Alpenwhale/PortfolioDisplayESP/docs/img/128x64/asset0_ytd.png

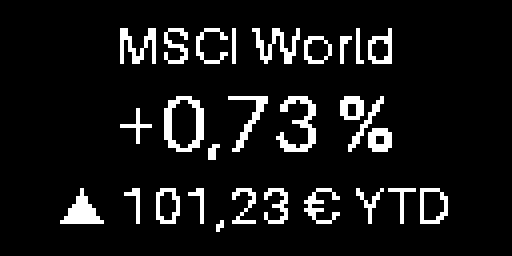
docs/img/128x64/asset0_ytd.png
