Alpenwhale/PortfolioDisplayESP/docs/img/128x64/asset3.png

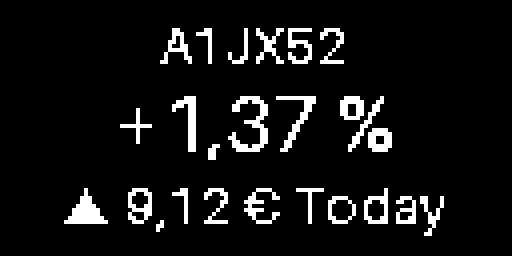
docs/img/128x64/asset3.png
