Alpenwhale/PortfolioDisplayESP/docs/img/128x64/boot.png

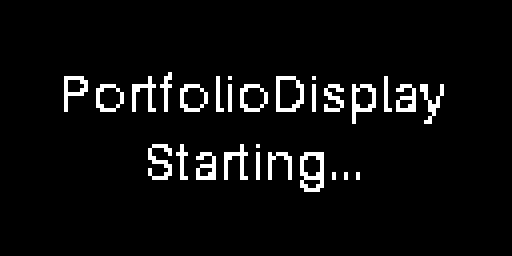
docs/img/128x64/boot.png
