Alpenwhale/PortfolioDisplayESP/docs/img/128x64/info1.png

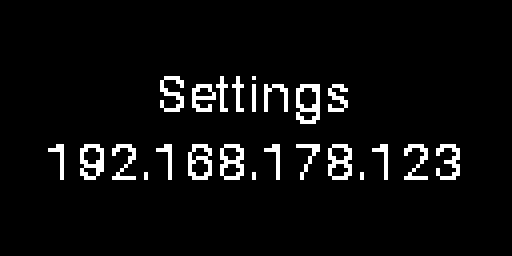
docs/img/128x64/info1.png
