Alpenwhale/PortfolioDisplayESP/docs/img/128x64/total_en.png

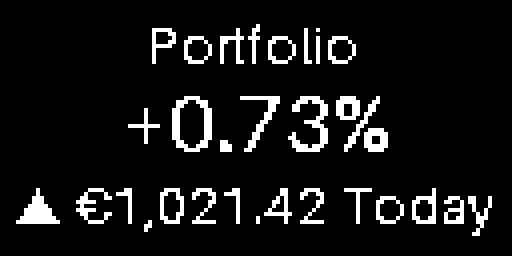
docs/img/128x64/total_en.png
