Alpenwhale/PortfolioDisplayESP/docs/img/128x64/total_minimal.png

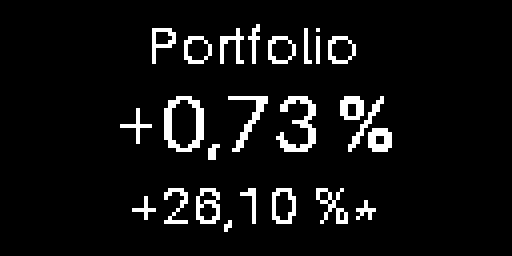
docs/img/128x64/total_minimal.png
