Alpenwhale/PortfolioDisplayESP/docs/img/128x64/total_novalue.png

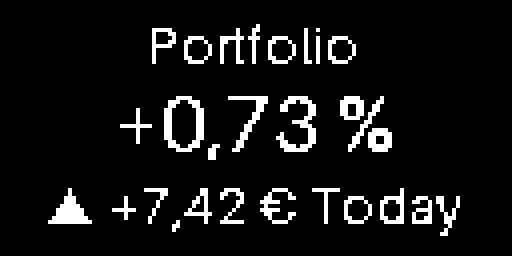
docs/img/128x64/total_novalue.png
