Alpenwhale/PortfolioDisplayESP/docs/img/320x240/asset3.png

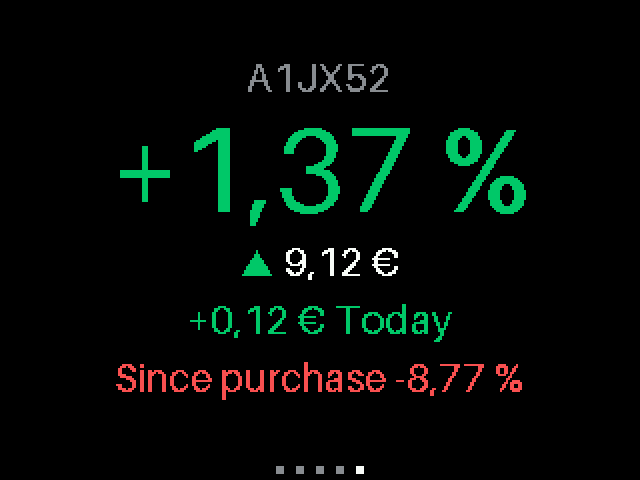
docs/img/320x240/asset3.png
