Alpenwhale/PortfolioDisplayESP/docs/img/320x240/boot.png

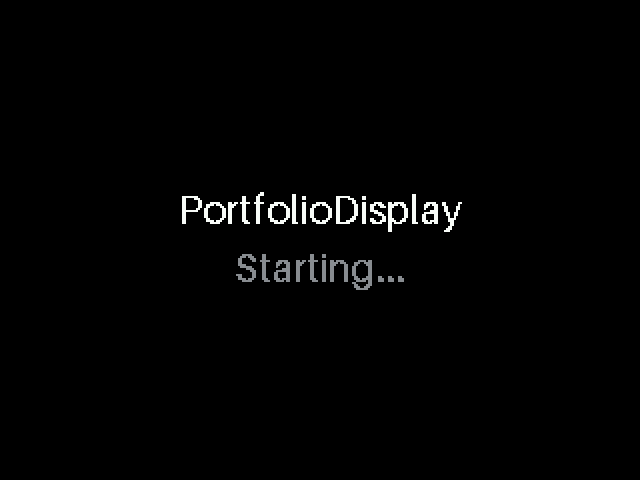
docs/img/320x240/boot.png
