Alpenwhale/PortfolioDisplayESP/docs/img/320x240/total_novalue.png

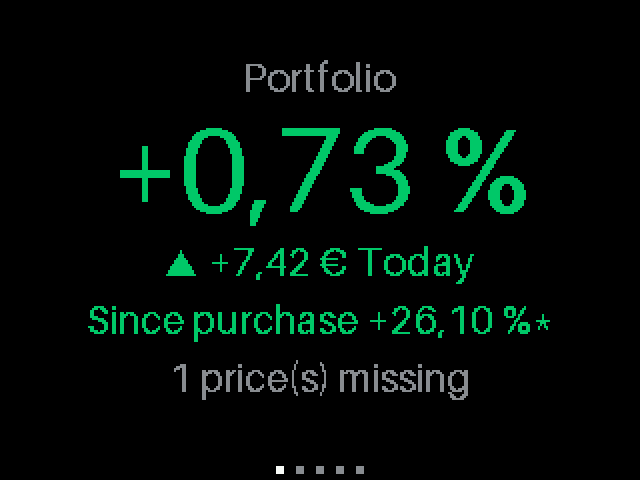
docs/img/320x240/total_novalue.png
