Alpenwhale/PortfolioDisplayESP/docs/img/portal/3_saved.png

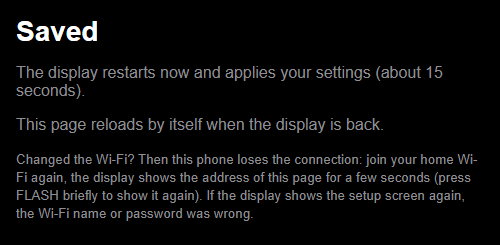
docs/img/portal/3_saved.png
