Alpenwhale/PortfolioDisplayESP/docs/img/portal/4_back_after_save.png

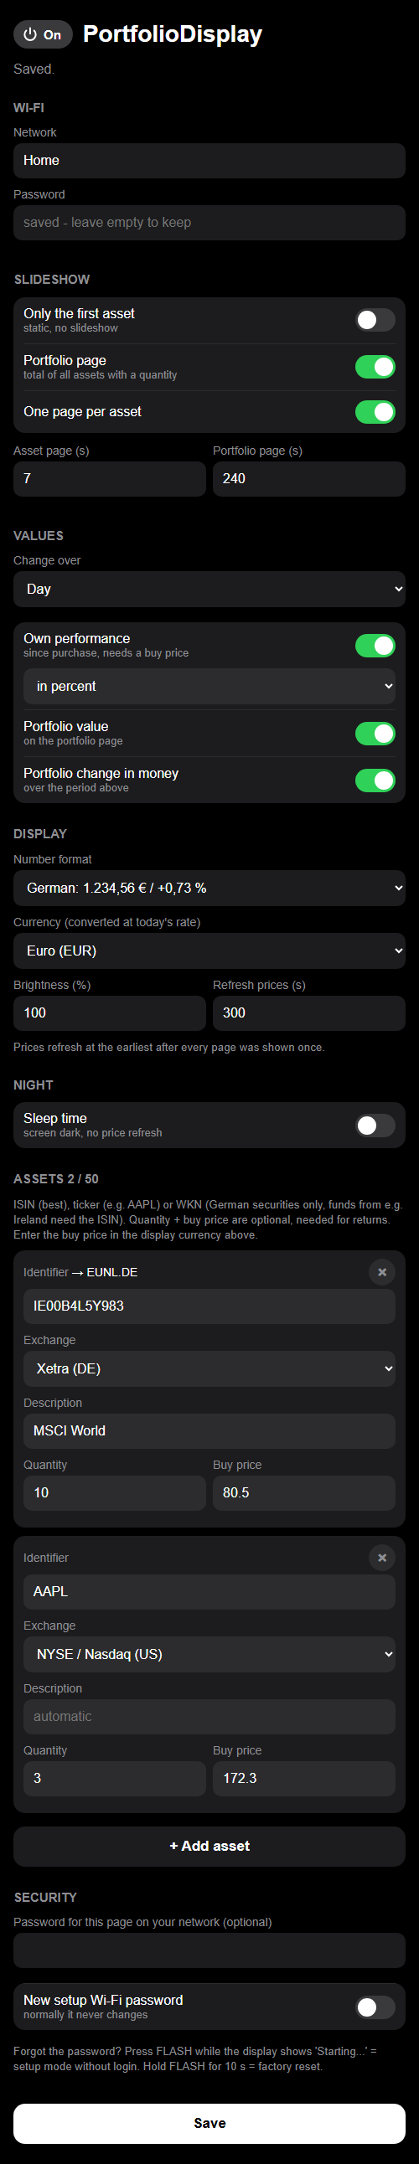
docs/img/portal/4_back_after_save.png
