Alpenwhale/PortfolioDisplayESP/3d/bambu/oled_case.3mf

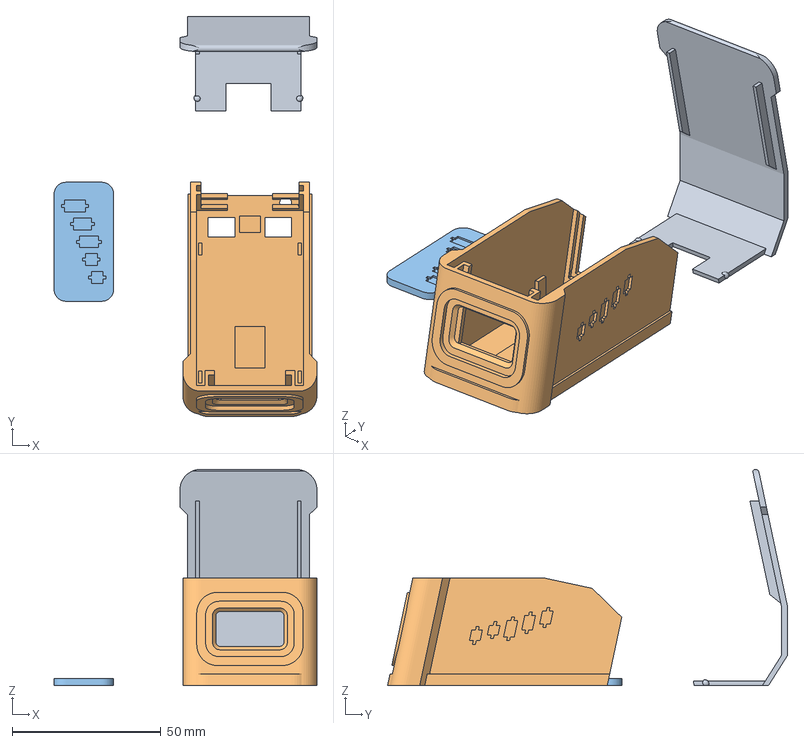
[picture p25: CAD file, 2026-11-12]
3d/bambu/oled_case.3mf
88.3 x 134.3 x 72.7 mm
oled_cover.stl
oled_shell.stl
warmup.stl
