Alpenwhale/PortfolioDisplayESP/3d/tft_case.3mf

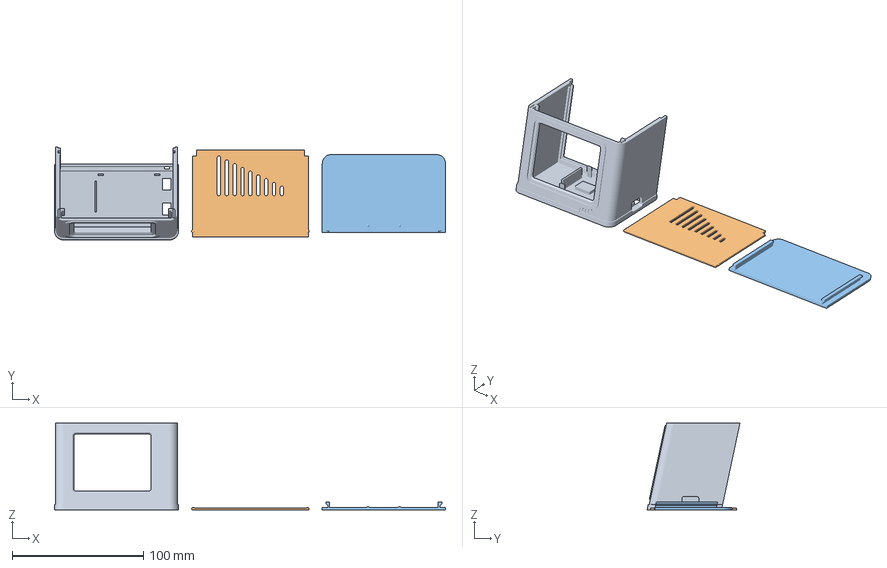
[picture p26: CAD file, 2026-11-12]
3d/tft_case.3mf
298.2 x 70.9 x 66.3 mm
tft_shell
tft_panel
tft_roof
