Alpenwhale/PortfolioDisplayESP/3d/bambu/tft_case.3mf

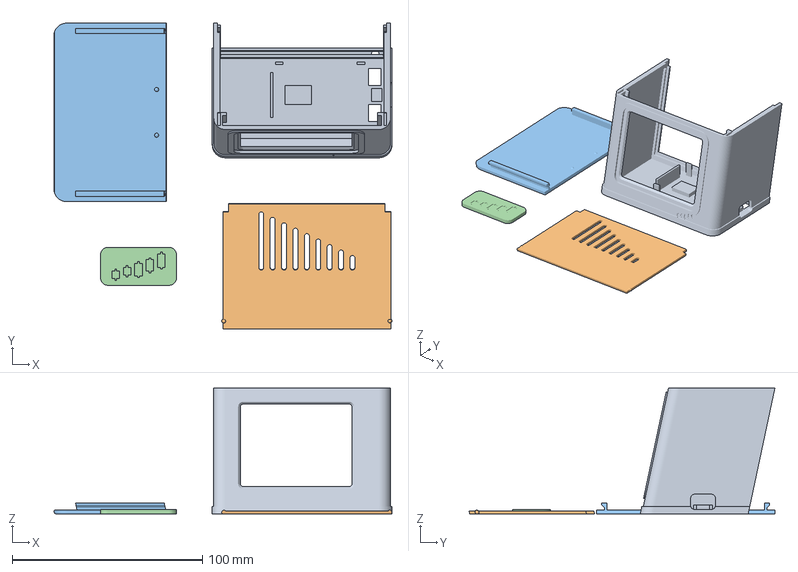
[picture p27: CAD file, 2026-11-12]
3d/bambu/tft_case.3mf
177.8 x 160.9 x 66.3 mm
tft_shell.stl
tft_panel.stl
tft_roof.stl
warmup.stl
