Alpenwhale/PortfolioDisplayESP/3d/oled_case.3mf

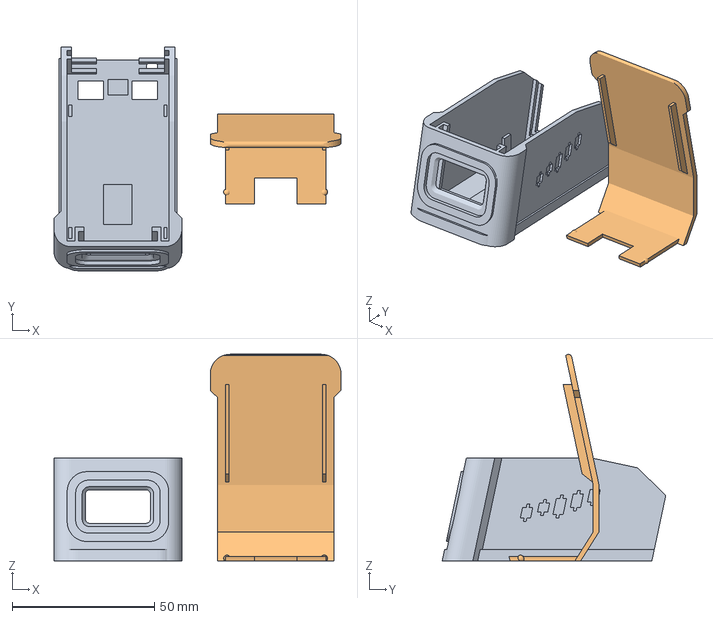
[picture p28: CAD file, 2026-11-12]
3d/oled_case.3mf
101.0 x 78.7 x 72.7 mm
oled_shell
oled_cover
