Alpenwhale/PortfolioDisplayESP/3d/tft_fit_frame.stl

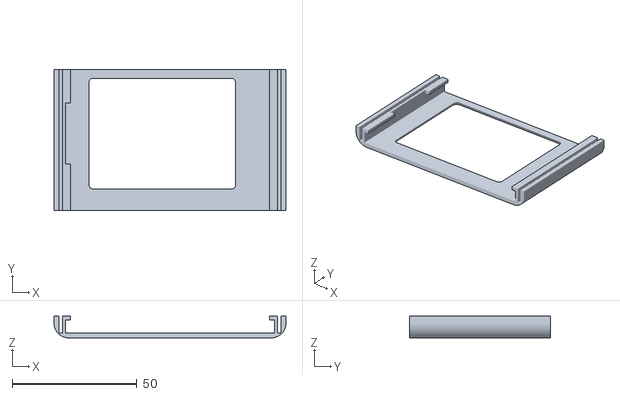
[picture p29: CAD file, 2026-11-12]
3d/tft_fit_frame.stl
93.0 x 56.5 x 8.81
