Alpenwhale/PortfolioDisplayESP/3d/oled_fit_frame.stl

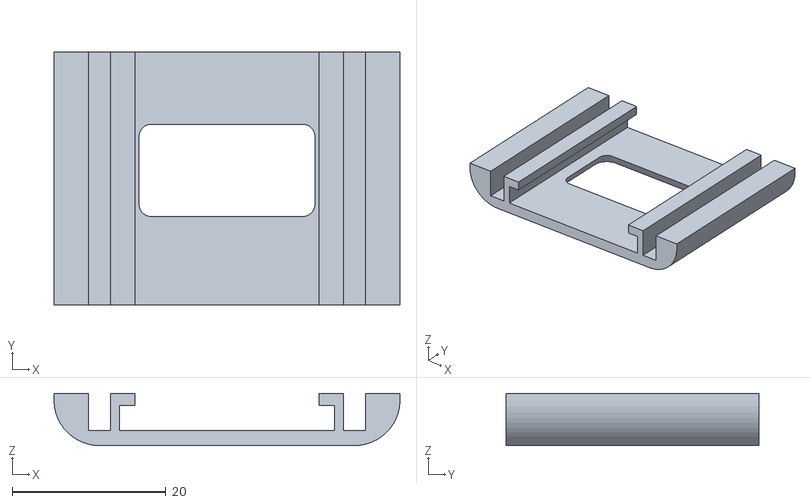
[picture p30: CAD file, 2026-11-12]
3d/oled_fit_frame.stl
45.0 x 32.9 x 6.81
