Alpenwhale/PortfolioDisplayESP/(commit log)

2026-11-08 init project, ili9341 driver
2026-11-08 tft without cs pin
2026-11-08 generic tft driver, display probes
2026-11-08 full init sequence, spi mode 3
2026-11-09 save form via reboot
    [app.py, main.py, portal.py, portal_shots.py, run.py]
2026-11-09 fetch after soft reset, keep the screen frozen
    [app.py, assets.py, boot.py, config.py, fetch.py, main.py, prices.py, run.py]
2026-11-10 real soft reset, no ip on loading screen
    [app.py, boot.py, config.py, fetch.py, main.py, reset.py]
2026-11-10 slideshow switches instead of mode, own time for the total page, percent as headline
2026-11-10 brightness: oled contrast, tft backlight pin or darker palette
2026-11-10 track fonts, ignore private notes
2026-11-11 switch for the portfolio value line
2026-11-11 sleep window with time zones and summer time, switch for the portfolio change line
2026-11-11 settings page: grouped sections, switches, hide what doesn't apply
    [portal_shots.py]
2026-11-12 3d printed desk cases for the tft and the oled
    [oled_case.3mf, oled_fit_frame.stl, tft_case.3mf, tft_fit_frame.stl]
2026-11-12 print-ready bambu studio projects for both cases
    [oled_case.3mf, tft_case.3mf]
2026-11-12 docs: nodemcu v3 dev board with usb-c
2026-11-12 tft case: back panel + sliding roof, covers exported with the tilt
    [oled_case.3mf, tft_case.3mf, tft_fit_frame.stl]
2026-11-12 display rest follows the tilt, reprint single parts
    [oled_case.3mf, tft_case.3mf]
2026-11-12 power button on the settings page
